telzo2000/coolpad13/README.md

# coolpad13

coolpad13 is QMK_Firmware powered, bluetooth enabled, 5 key macropad keyboard.
<br>
coolpad13はQMK_Firmwareで動き、ブルートゥース対応で、５キーのマクロパッドキーボードです。
<br>
Some firmware is also for pro micro.
<br><br>
ファームウェアの中には、pro micro用のものもあります。
<br>

## Firmware
https://github.com/telzo2000/coolpad13/tree/main/firmware

## PArts list
| No. | Patrs | Quantity | remarks | Suppliers | Cost |
|--|--|--|--|--|--|
|番号|名前|数|備考|調達先|参考価格（送料込）|<br>
|1|PCB|1|5key|[elecrow](https://www.elecrow.com)<br>[JLCPCB](https://jlcpcb.com)<br>[ALLPCB](https://www.allpcb.com)|５枚で10〜20ドル|<br>
|2|Switch Plate|1||↑|↑|<br>
|3|Bottom Plate|1||↑|↑|<br>
|4| pro micro|1|コンスルー推奨|[遊舎工房](https://yushakobo.jp)<br>[Talp Keyboard](https://talpkeyboard.net)<br>[Daily Craft Keyboard](https://shop.dailycraft.jp)等|800円|
|5|Switch Socket|５|使用せず、直接はんだ付けも可能|[遊舎工房](https://yushakobo.jp)<br>[Talp Keyboard](https://talpkeyboard.net)<br>[Daily Craft Keyboard](https://shop.dailycraft.jp)等|10個で165円程度から|
|6|リセット用タクトスイッチ|1||[遊舎工房](https://yushakobo.jp)<br>[Talp Keyboard](https://talpkeyboard.net)<br>[Daily Craft Keyboard](https://shop.dailycraft.jp)等|１個11円程度|
|7|M２ネジ|４|３〜６mmのもの|DIYショップなど|10本で100円程度|
|8|M２ネジ|４|８mm|DIYショップなど|10本で100円程度|
|9|M２スペーサー|４|3.5mm|DIYショップなど|10本で440円程度|
|10|M２スペーサー|４|8mm|DIYショップなど|10本で440円程度|

In addition, you will need a USB cable, keycaps, etc.
<br>
この他に、USBケーブル、キースイッチ、キーキャップ等が必要です。
<br>
<br>

### 有線接続を希望する場合

| No. | Patrs | Quantity | remarks | Suppliers | Cost |
|--|--|--|--|--|--|
|番号|名前|数|備考|調達先|参考価格（送料込）|<br>
|1|pro micro|1|コンスルー推奨|[遊舎工房](https://yushakobo.jp)等||

### Bluetooth接続を希望する場合(1)

|No. | Patrs | Quantity | remarks | Suppliers | Cost |
|--|--|--|--|--|--|
|番号|名前|数|備考|調達先|参考価格（送料込）|<br>
|1|BLE Micro Pro|1|Bluetooth対応pro micro、コンスルー推奨|[遊舎工房](https://yushakobo.jp)等|5000円程度|
|2|電池基板|||[遊舎工房](https://shop.yushakobo.jp/products/ble-micro-pro-battery-board?variant=37665283211425)等|500円程度|

### Bluetooth接続を希望する場合(2)

| No. | Patrs | Quantity | remarks | Suppliers | Cost |
|--|--|--|--|--|--|
|番号|名前|数|備考|調達先|参考価格（送料込）|<br>
|1|BLE Micro Pro|1|Bluetooth対応pro micro、コンスルー推奨|[遊舎工房](https://yushakobo.jp)等|5000円程度|
|2|コンデンサ|1||[秋月電子](https://akizukidenshi.com/catalog/g/gP-02151/)|10個200円|
|3|水平スライドスイッチ|1||[遊舎工房](https://shop.yushakobo.jp/products/5624?variant=45044666007783)|1個110円|
|4|電池ホルダ|1||[モノタロウ](https://www.monotaro.com/p/8835/2765/)|1個263円|

## Build guide

https://github.com/telzo2000/coolpad13/blob/main/buildguide_for_coolpad13.md
