telzo2000/coolpad13/firmware/readme.md

# Firmware

Support QMK_Firmware.
<br>
QMK_Firmwareに対応。
<br>
<br>
Compatible with [VIA](https://usevia.app/).
<br>
[VIA](https://usevia.app/)に対応。
<br>
File name: coolpad13_via.hex
<br>
<br>
Compatible with [VIAL](https://get.vial.today/).
<br>
[VIAL](https://get.vial.today/)に対応。
<br>
File name: coolpad13_vial.hex
<br>
<br>
I can not answer questions such as setting of BLE Micro Pro or Remap,etc.
<br>
<br>
Although the text is in Japanese, here is an article that shows examples of how to set up BLE Micro Pro.
<br>

https://sizu.me/m_ki/posts/x1mh846sx3zd
