telzo2000/coolpad13/buildguide_for_coolpad13.md

# Build guide

## 1 Cutting parts

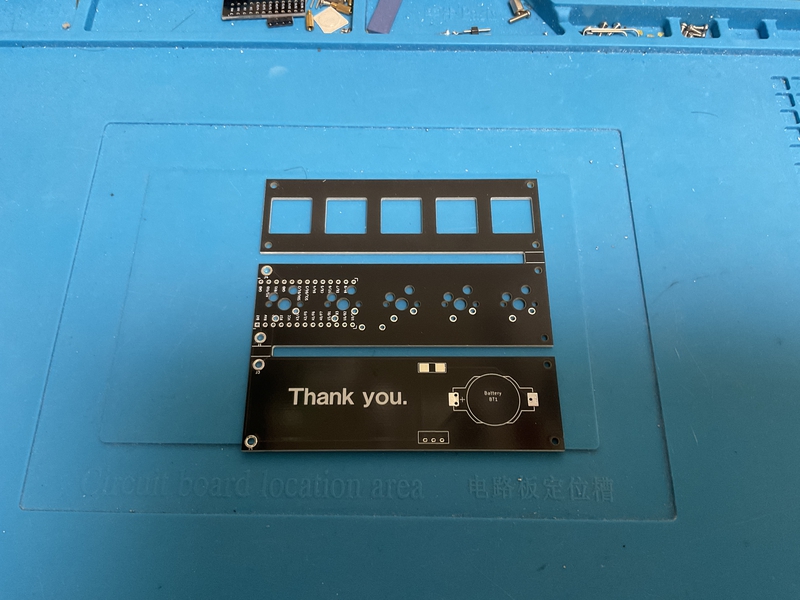
[picture p1: img/img00001.jpg]


Use nippers to cut the board into three pieces.
<br>
ニッパーなどを使い、基板を３つに切り分けましょう。
<br>

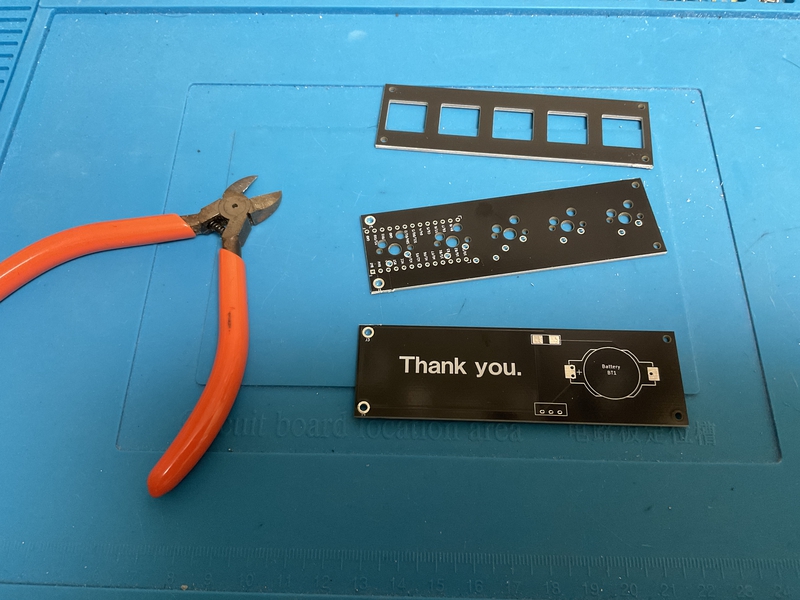
[picture p2: img/img00002.jpg]


File the cut section.
<br>
切り取った断面をやすりがけしましょう。
<br>

Some versions are already cut out.
<br>
既に切り分けられているバージョンもあります。
<br>

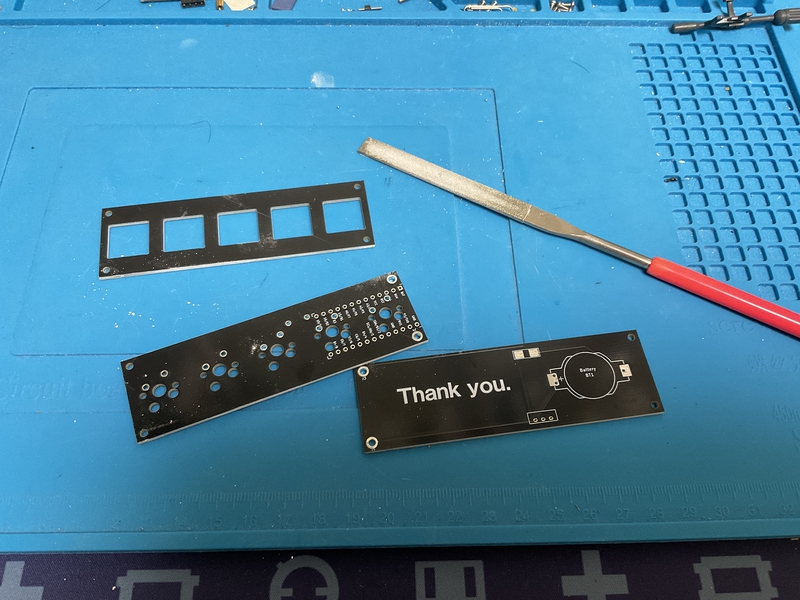
[picture p3: img/img00003.jpg]


Paint the sides of all the boards with a black pen for a clean finish.
<br>
全ての基板の側面を黒色ペンで塗ると綺麗に仕上がります。
<br>
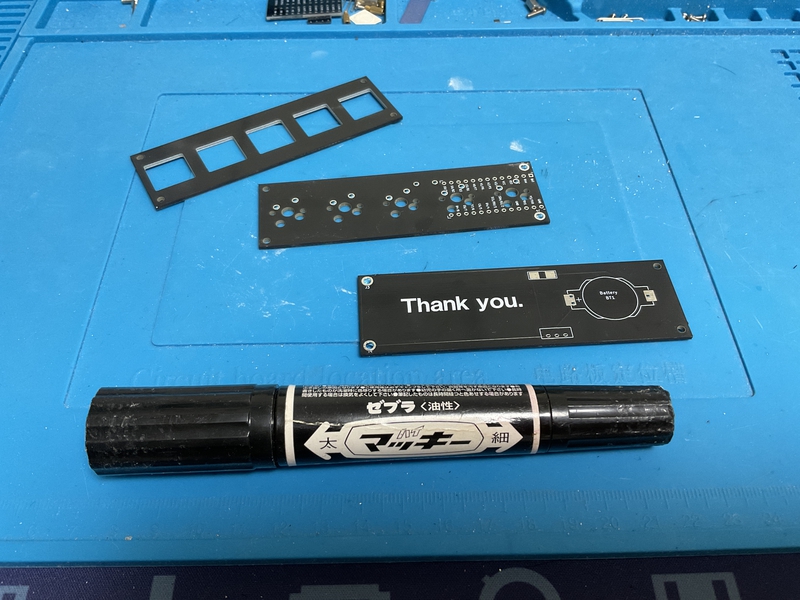
[picture p4: img/img00004.jpg]


## 2 Soldering switch socket

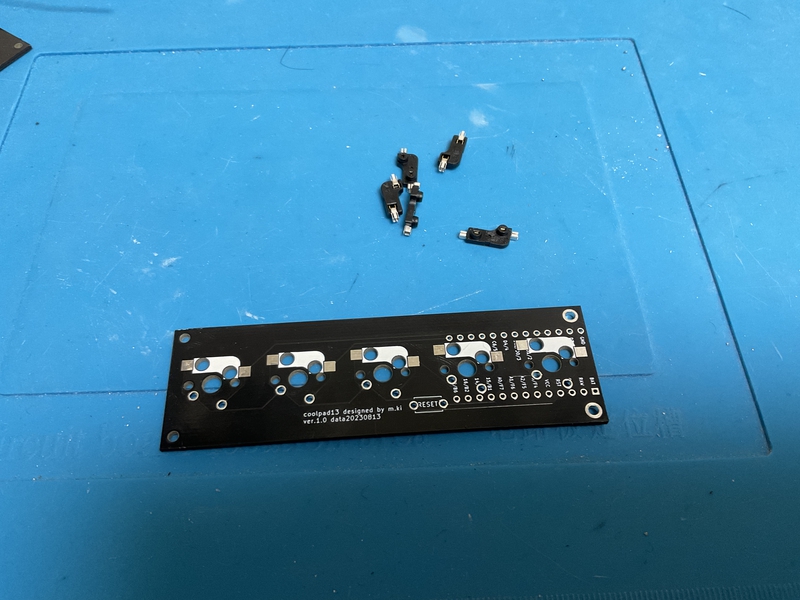
[picture p5: img/img00005.jpg]


Apply solder to one side of the terminal.
<br>
端子の片側にハンダを盛りましょう。
<br>

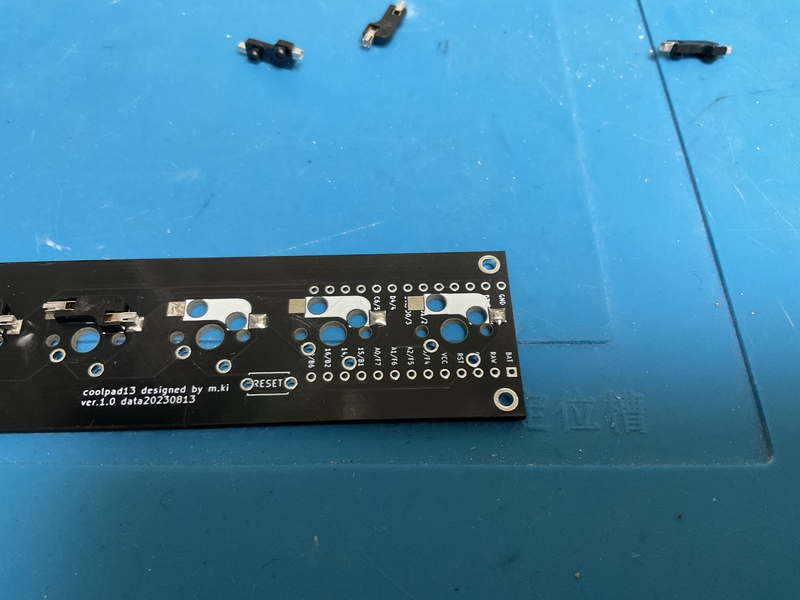
[picture p6: img/img00006.jpg]


Let's put the switch socket on the board according to the silk and solder it.
<br>
基板のシルクに合わせてスイッチソケットを乗せて、ハンダ付けしましょう。
<br>

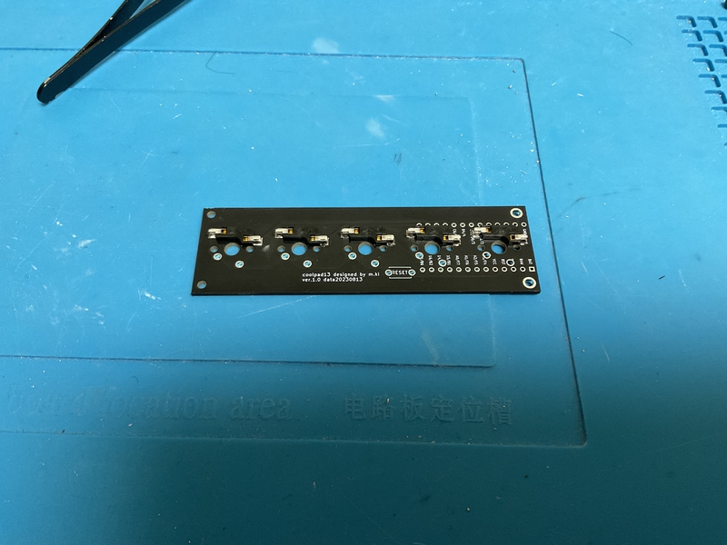
[picture p7: img/img00007.jpg]


## 3 Soldering tact switch

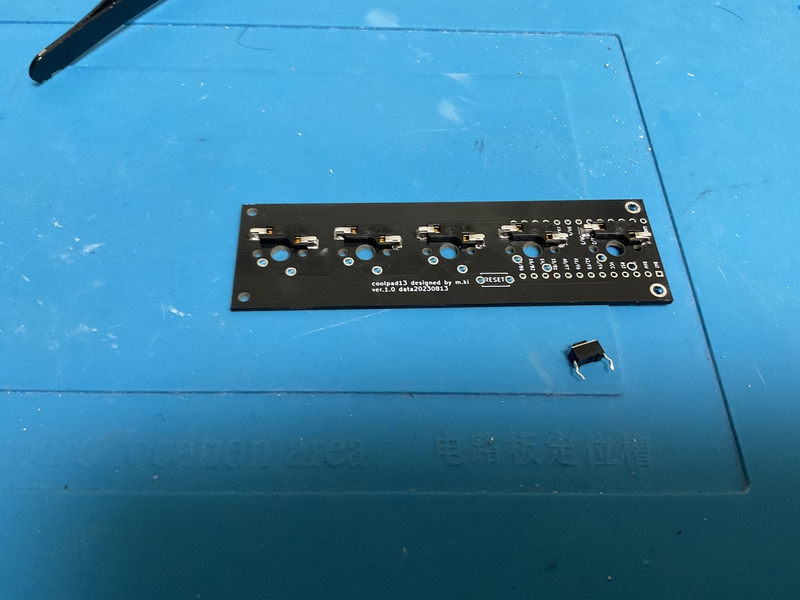
[picture p8: img/img00008.jpg]


Insert the tact switch into the side where you soldered the switch socket, and solder it on the other side.
<br>
スイッチソケットをハンダ付けした面に、タクトスイッチを差し込んで、反対の面でハンダ付けしてください。
<br>

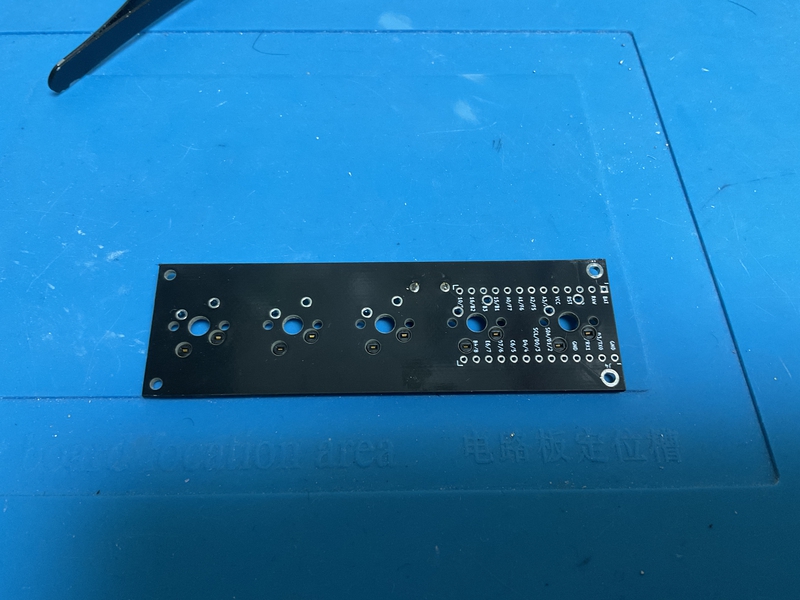
[picture p9: img/img00009.jpg]


## 4 Soldering battery part

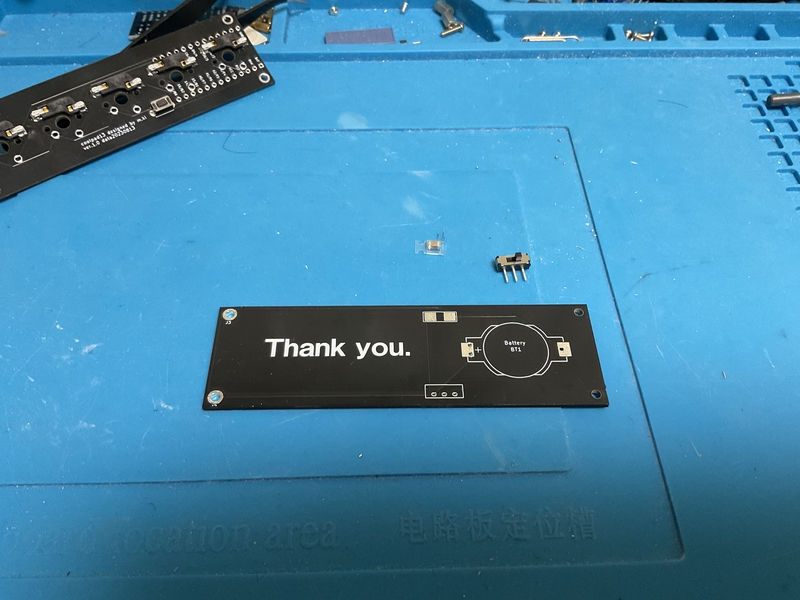
[picture p10: img/img00010.jpg]


Install the capacitor and horizontal slide switch first. You can successfully solder a capacitor by applying solder to one side of the terminal, placing the capacitor, and melting the solder.
<br>
最初にコンデンサと水平スライドスイッチを取り付けます。コンデンサは、端子の片側にハンダを盛ってから、コンデンサを置き、ハンダを溶かすようにすると、上手にハンダ付けできます。
<br>

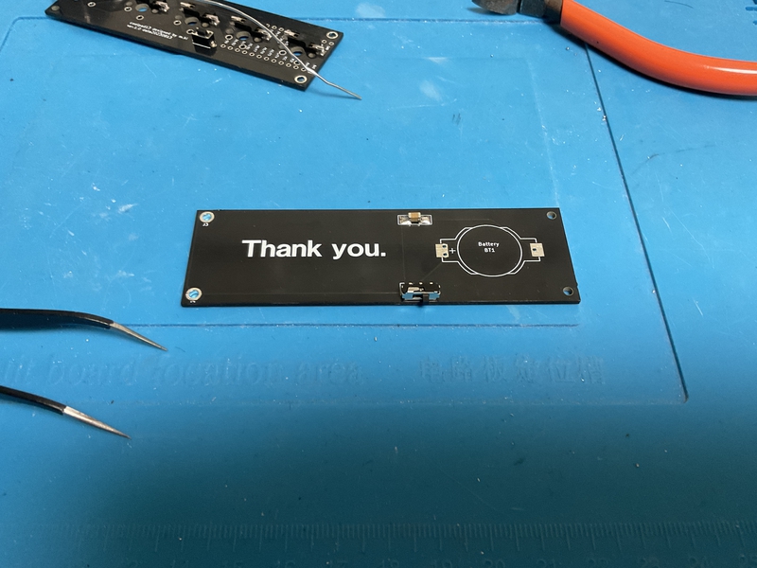
[picture p11: img/img00011.jpg]


Next, place the battery holder. Solder the terminals on the back side (bottom side).
<br>
次に、電池ホルダを置きます。裏面（下側）に出た端子にハンダ付けをします。
<br>

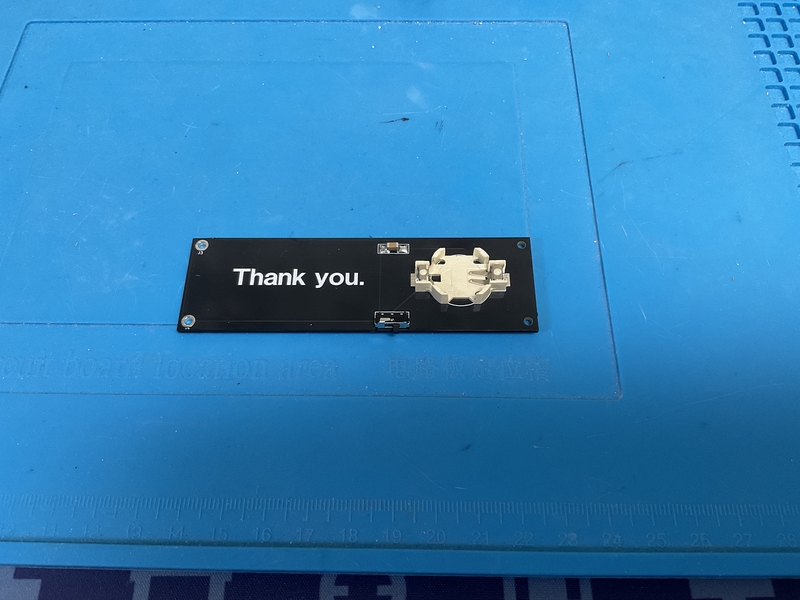
[picture p12: img/img00012.jpg]


Cut off the terminals protruding from the back using nippers.
<br>
裏面に出ている端子はニッパーなどで切り取ってください。
<br>

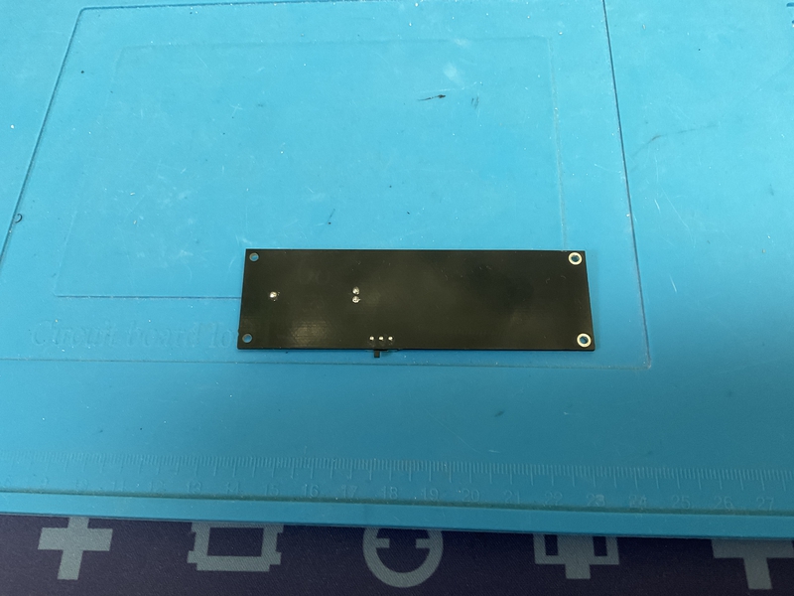
[picture p13: img/img00013.jpg]


## 5 insert switch

Prepare 5 key switches and insert them into the switch plate.
<br>
５つのキースイッチを用意して、スイッチプレートに差し込んでください。
<br>

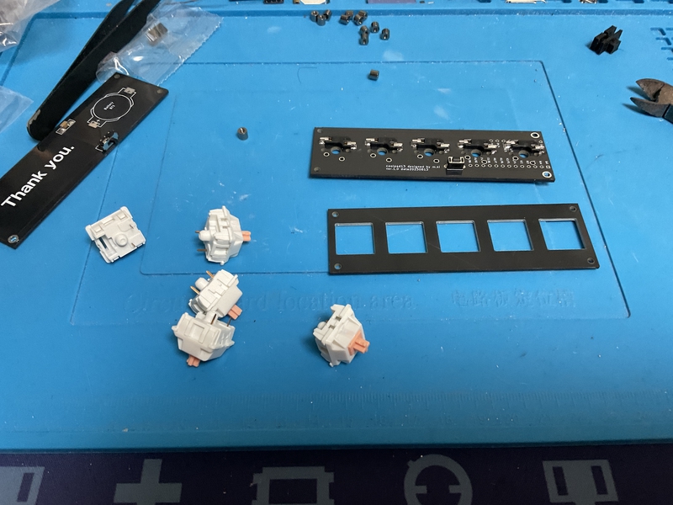
[picture p14: img/img00014.jpg]


Insert M2 screws (8mm) into the four screw holes from the top of the switch plate, and fix them with M2 spacers (3.5mm) from the bottom. Once you have them, pass them through the screw holes on the board and secure them with M2 spacers (8mm) on the underside of the board.
<br>
スイッチプレート上側から４つのネジ穴に、M2ネジ（8mm）を挿入して、下側からM2スペーサー（3.5mm）で固定してください。それらができたら、基板のネジ穴に通して基板の下側でM2スペーサー（8mm）で固定してください。
<br>

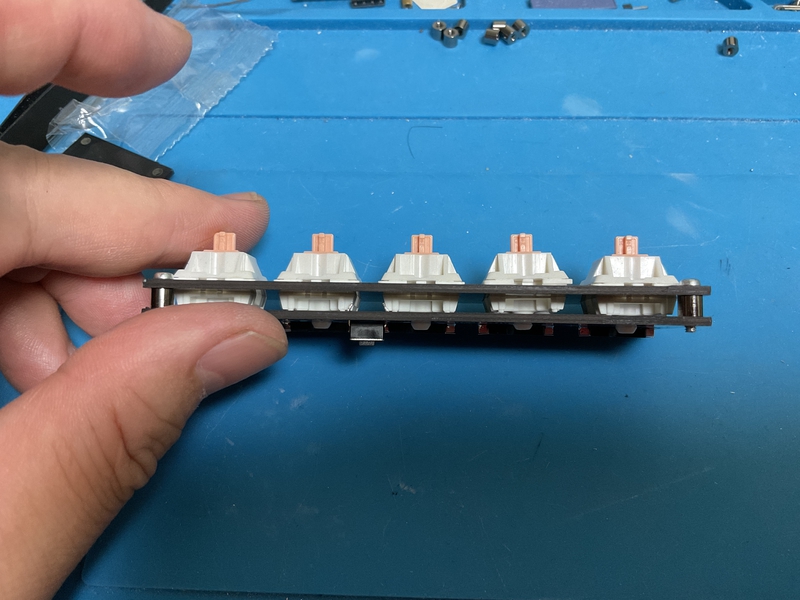
[picture p15: img/img00015.jpg]


Insert four M2 screws (3mm) from the bottom to secure the bottom plate.Don't forget to insert the CR1632 battery.
<br>
ボトムプレートは下側からM2ネジ（3mm）４本を挿入して固定してください。CR1632の電池の挿入を忘れずにしてください。
<br>
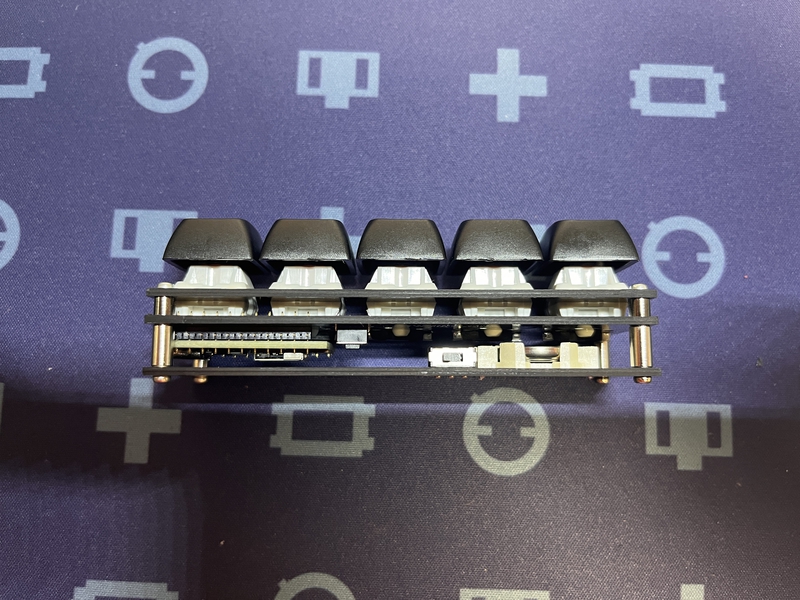
[picture p16: img/img00017.jpg]


Just attach your favorite keycaps and you're done.
<br>
お気に入りのキーキャップを装着すれば、完成です。

<br>

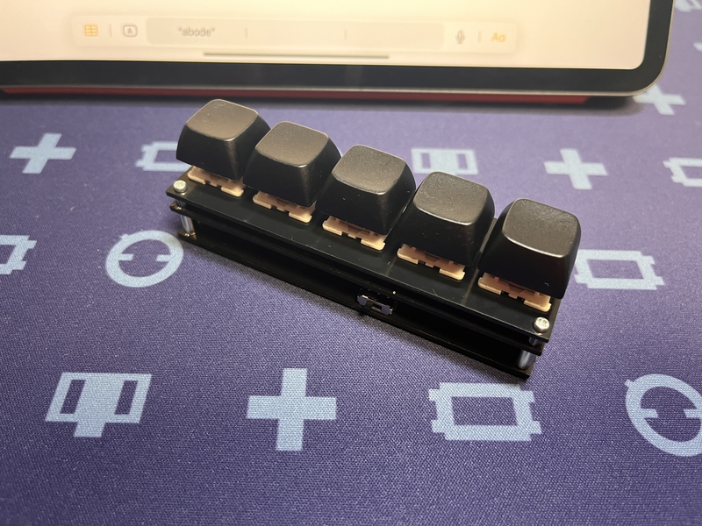
[picture p17: img/img00016.jpg]


Have a fun keyboard life!
<br>
楽しいキーボード生活を！
